phlmn/drynkit-pcb/README.md

# drynk.it PCB

## Repository Structure

| Folder | Description |
| --- | --- |
| board | The KiCAD files for the PCB |
| bugs | Known bugs and fixes for boards |
| datasheets | Relevant datasheets |
