phlmn/drynkit-pcb/board/scale.kicad_pcb

## KiCad design board/scale.kicad_pcb (2020-07-19)

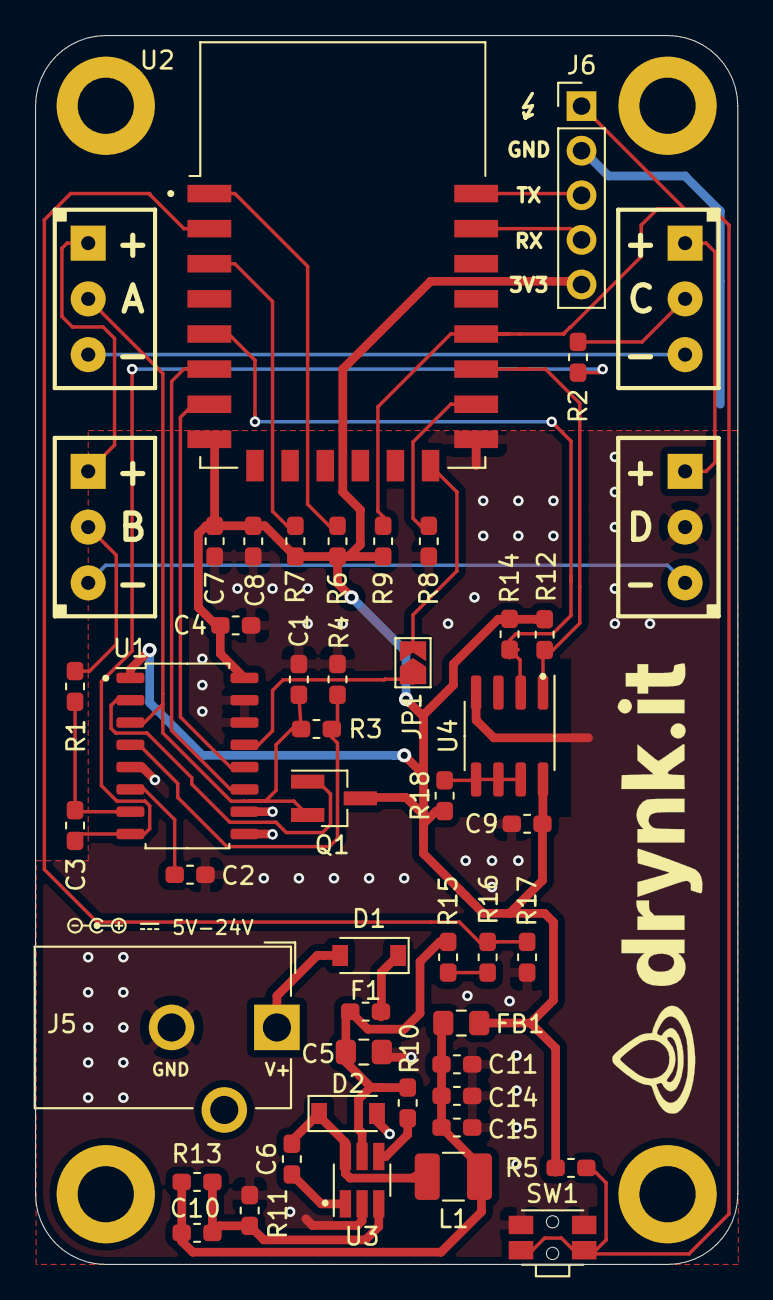
[picture p1: board scale.kicad_pcb from above]

Board: 2 copper layers, 40.0 x 70.0 mm, 49 parts (0 on the bottom side), 37 nets.

Parts:
C1, C4, C7, C11: 10uF; C_0603_1608Metric_Pad1.05x0.95mm_HandSolder
C2, C3, C9: 0.1uF; C_0603_1608Metric_Pad1.05x0.95mm_HandSolder
C5: 4.7uF/25V; C_0805_2012Metric_Pad1.15x1.40mm_HandSolder
C6, C8: 100nF; C_0603_1608Metric_Pad1.05x0.95mm_HandSolder
C10: 33pF; C_0603_1608Metric_Pad1.05x0.95mm_HandSolder
C14, C15: DNP; C_0603_1608Metric_Pad1.05x0.95mm_HandSolder
D1, D2: B5819W; D_SOD-123
F1: 500mA/24V (CFS06V3T1R0); Fuse_0603_1608Metric_Pad1.05x0.95mm_HandSolder
FB1: GZ2012D601TF; L_0805_2012Metric_Pad1.15x1.40mm_HandSolder
J1: Cell A; SolderWirePad_1x03_P3.175mm_Drill0.8mm
J2: Cell B; SolderWirePad_1x03_P3.175mm_Drill0.8mm
J3: Cell C; SolderWirePad_1x03_P3.175mm_Drill0.8mm
J4: Cell D; SolderWirePad_1x03_P3.175mm_Drill0.8mm
J5: Jack-DC; BarrelJack_CUI_PJ-102AH_Horizontal
J6: Conn_01x05; PinHeader_1x05_P2.54mm_Vertical
JP1: Jumper_NO_Small; SolderJumper-2_P1.3mm_Open_TrianglePad1.0x1.5mm
L1: 2.2 - 4.7uH; L_1210_3225Metric_Pad1.42x2.65mm_HandSolder
Q1: Q_PNP_BCE; SOT-23_Handsoldering
R1, R2: 100; R_0603_1608Metric_Pad1.05x0.95mm_HandSolder
R3: 20K; R_0603_1608Metric_Pad1.05x0.95mm_HandSolder
R4: 8.2K; R_0603_1608Metric_Pad1.05x0.95mm_HandSolder
R5, R6, R7, R8, R9, R10, R12, R14, R17, R18: 4.7k; R_0603_1608Metric_Pad1.05x0.95mm_HandSolder
R11: 24k; R_0603_1608Metric_Pad1.05x0.95mm_HandSolder
R13, R15, R16: 75k; R_0603_1608Metric_Pad1.05x0.95mm_HandSolder
SW1: SW_Push; SW_SPST_EVQP7C
U1: HX711; SOP-16_4.55x10.3mm_P1.27mm
U2: ESP-12E
U3: MP2451; SOT-23-6_Handsoldering
U4: LM75B; SOIC-8_3.9x4.9mm_P1.27mm

Connections:
+3V3: C4.1, C7.2, C8.2, C9.1, FB1.2, J6.5, Q1.3, R5.1, R6.2, R7.2, R9.2, R12.1, R14.2, R18.2, U1.1, U1.16, U2.8, U4.8
+VDC: D1.2, J5.1
/ADC_CLK: JP1.1, U1.13
/ADC_DOUT: U1.12, U2.7
/ADC_SCK: U1.11, U2.6
/BOOTLOADER: J6.1, R5.2, R9.1, SW1.2, U2.18
/CELL_E+: C1.1, J1.2, Q1.2, R3.1, U1.3
/CELL_S+: J3.2, R2.2
/CELL_S-: J2.2, R1.2
/RX: J6.4, U2.21
/SCL: R14.1, U2.5, U4.2
/SDA: R12.2, U2.17, U4.1
/TX: J6.3, U2.22
/V_SENSE: C5.1, F1.1, R10.2, R15.1, U3.5
GND: C1.2, C2.1, C4.2, C5.2, C7.1, C8.1, C9.2, C11.2, C14.1, C15.1, D2.2, J4.2, J5.2, J6.2, R4.2, R8.2, R11.2, R17.1, SW1.1, U1.5, U1.9, U1.10, U1.14, U1.15, U2.15, U3.2, U4.4
unnamed: C2.2, U1.6
unnamed: C3.1, R1.1, U1.7
unnamed: C3.2, R2.1, U1.8
unnamed: C6.1, U3.1
unnamed: C6.2, D2.1, L1.1, U3.6
unnamed: C10.1, C11.1, C14.2, C15.2, FB1.1, L1.2, R13.2
unnamed: C10.2, R11.1, R13.1, U3.3
unnamed: D1.1, F1.2
unnamed: J1.1, J2.1
unnamed: J1.3, J3.3
unnamed: J2.3, J4.3
unnamed: J3.1, J4.1
unnamed: JP1.2, U2.14
unnamed: Q1.1, U1.2
unnamed: R3.2, R4.1, U1.4
unnamed: R6.1, U2.1
unnamed: R7.1, U2.3
unnamed: R8.1, U2.16
unnamed: R10.1, U3.4
unnamed: R15.2, R16.2
unnamed: R16.1, R17.2, U2.2
unnamed: R18.1, U4.5, U4.6, U4.7
