phlmn/drynkit-pcb/bugs/prototype-01/README.md

# Bugs: Prototype 01

## Floating I2C Address Pins on Temp Sensor

### Bug

Pins A0, A1 and A2 are floating. They have to be GND or 3V3.

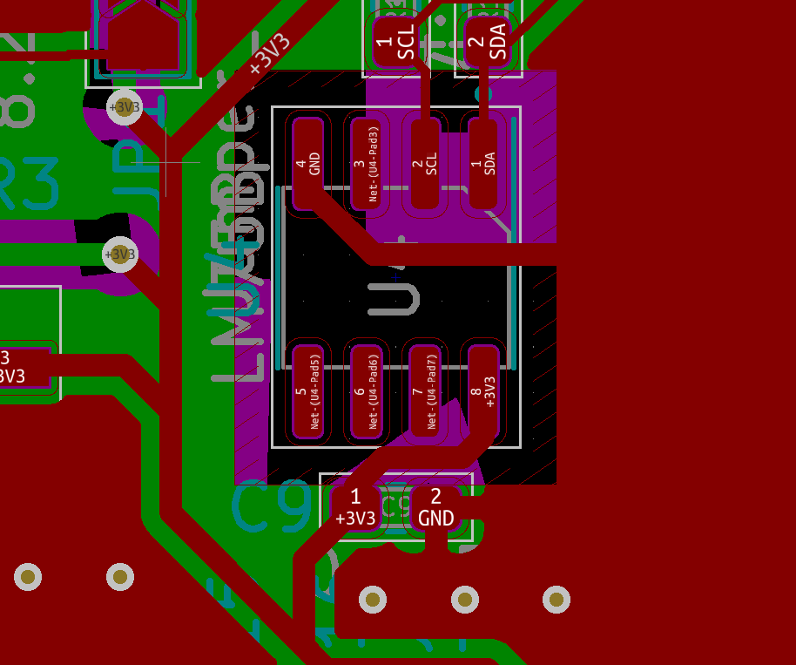
[picture p2: bugs/prototype-01/temp-floating-i2c.png]
Image of Bug on the PCB


### Fix

Connect Pin A0, A1 and A2 to 3V3 since they are near it. This results in I2C Address `1001111`.
