phlmn/drynkit-pcb/(commit log)

2020-07-10 temp: Fix floating i2c address pins
    [scale.sch]
2020-07-10 Add datasheets
    [scale.kicad_pcb, scale.sch, scale_bom_jlc.csv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]
2020-07-10 i2c Bug: Add more information
2020-07-19 LM75 i2c address resistor
    [scale.sch]
2020-07-19 Fix polarity graphics
    [scale.kicad_pcb]
2020-07-19 Place resistor for TMP75
    [scale.kicad_pcb, scale.sch]
